naori-1/avto-poliv/smeta.md

# Смета

Цены на октябрь 2026. Ноутбук, USB-кабель, горшок с растением и ёмкость для воды в смету не входят.

| № | Деталь | Кол-во | Цена, сом | Сумма, сом | Где купили |
|---|---|---|---|---|---|
| 1 | Плата ESP32 (ZY-ESP32 Dev Board, 30 pin) | 1 | 600 | 600 | AliExpress |
| 2 | Ёмкостный датчик влажности почвы v1.2 | 1 | 150 | 150 | AliExpress |
| 3 | 1-канальный модуль реле 5V | 1 | 120 | 120 | AliExpress |
| 4 | Мини-помпа 5V с силиконовой трубкой | 1 | 250 | 250 | AliExpress |
| 5 | Макетная плата MB-102 (830 точек) | 1 | 180 | 180 | AliExpress |
| 6 | Провода «папа-папа» и «папа-мама» | 2 набора | 75 | 150 | AliExpress |
| 7 | Светодиоды 5 мм: зелёный, красный, синий | 3 | 10 | 30 | AliExpress |
| 8 | Резисторы 220 Ом | 3 | 5 | 15 | AliExpress |
| | **Итого** | | | **1495** | |
